CSavoy78/Maverick-DAQ/PCB/Maverick DAQ.kicad_pcb

## KiCad design PCB/Maverick DAQ.kicad_pcb (2025-04-01)

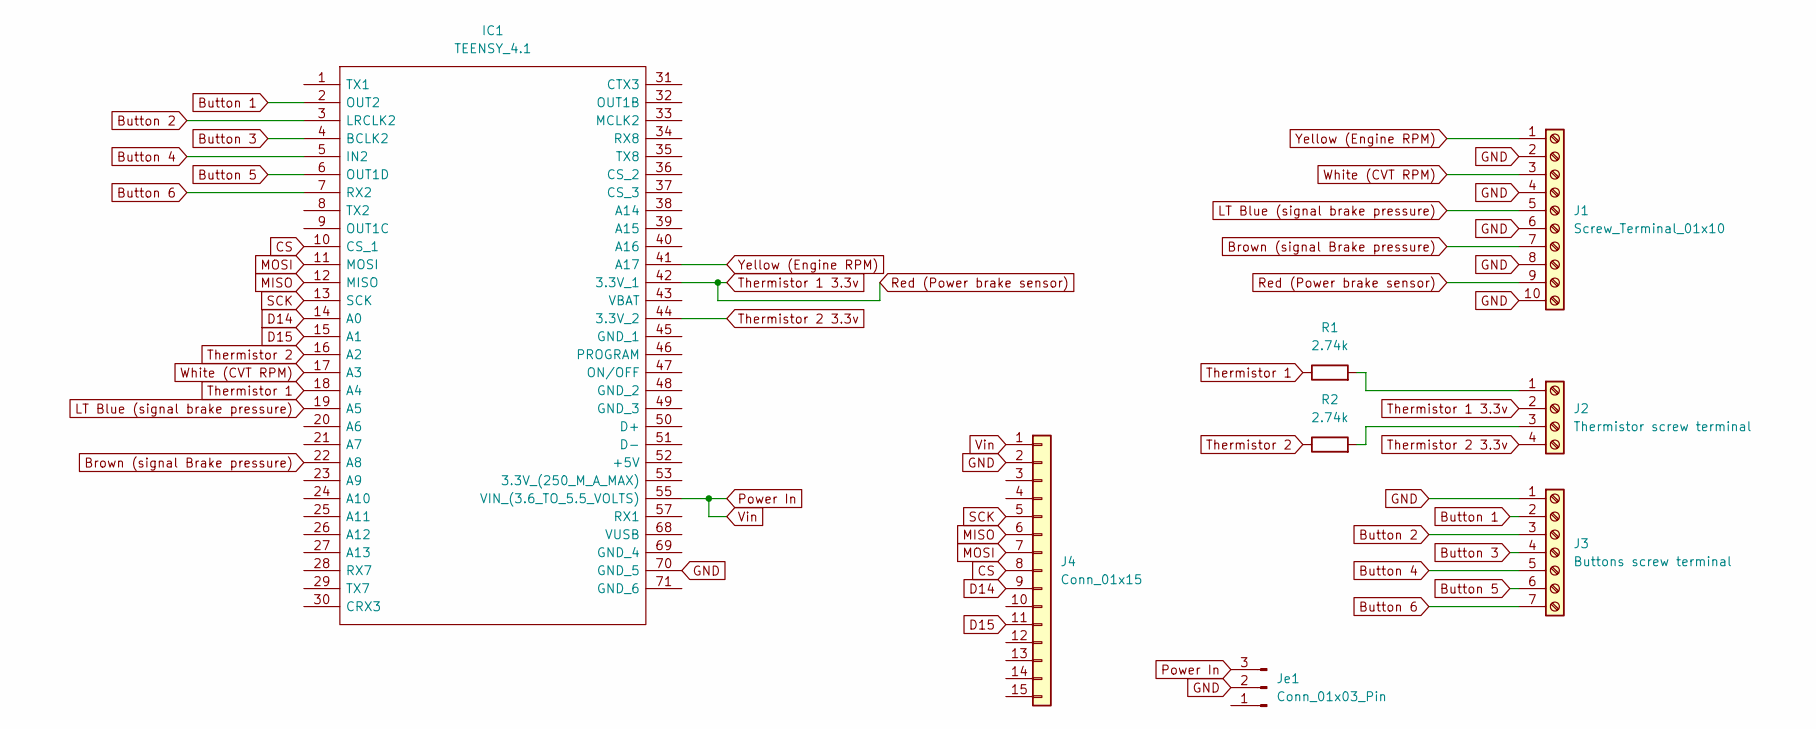
[picture p1: schematic Maverick DAQ.kicad_sch]

Parts:
IC1: TEENSY_4.1; TEENSY41; Manufacturer_Part_Number TEENSY 4.1
J1: Screw_Terminal_01x10; PinHeader_1x10_P2.54mm_Vertical
J2: Thermistor screw terminal; PinSocket_1x04_P2.54mm_Vertical
J3: Buttons screw terminal; PinSocket_1x07_P2.54mm_Vertical
J4: Conn_01x15; PinSocket_1x15_P2.54mm_Vertical
Je1: Conn_01x03_Pin; PinHeader_1x03_P2.54mm_Vertical
R1, R2: 2.74k; R_0402_1005Metric_Pad0.72x0.64mm_HandSolder

Connections:
Brown (signal Brake pressure): IC1.22 (A8), J1.7
Button 1: IC1.2 (OUT2), J3.2
Button 2: IC1.3 (LRCLK2), J3.3
Button 3: IC1.4 (BCLK2), J3.4
Button 4: IC1.5 (IN2), J3.5
Button 5: IC1.6 (OUT1D), J3.6
Button 6: IC1.7 (RX2), J3.7
CS: IC1.10 (CS_1), J4.8
D14: IC1.14 (A0), J4.9
D15: IC1.15 (A1), J4.11
GND: IC1.70 (GND_5), J1.2, J1.4, J1.6, J1.8, J1.10, J3.1, J4.2, Je1.2
LT Blue (signal brake pressure): IC1.19 (A5), J1.5
MISO: IC1.12 (MISO), J4.6
MOSI: IC1.11 (MOSI), J4.7
unnamed: J2.1, R1.2
unnamed: J2.3, R2.2
Power In: IC1.55 (VIN_(3.6_TO_5.5_VOLTS)), J4.1, Je1.3
Red (Power brake sensor): IC1.42 (3.3V_1), J1.9, J2.2
SCK: IC1.13 (SCK), J4.5
Thermistor 1: IC1.18 (A4), R1.1
Thermistor 2: IC1.16 (A2), R2.1
Thermistor 2 3.3v: IC1.44 (3.3V_2), J2.4
White (CVT RPM): IC1.17 (A3), J1.3
Yellow (Engine RPM): IC1.41 (A17), J1.1

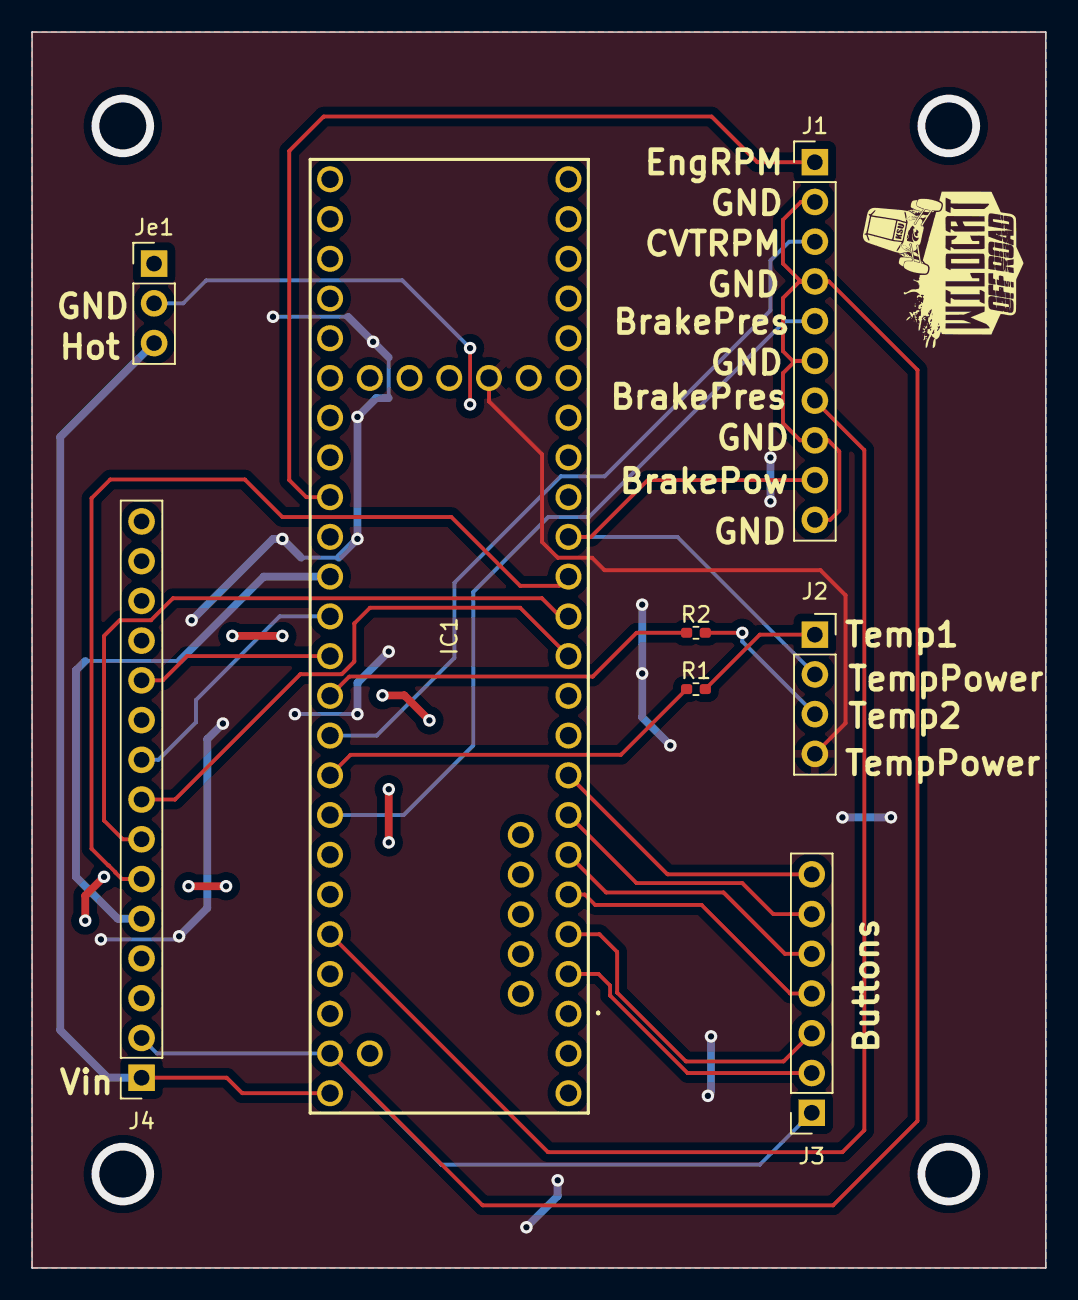
[picture p2: board Maverick DAQ.kicad_pcb from above]

Board: 2 copper layers, 64.8 x 79.0 mm, 8 parts (0 on the bottom side), 24 nets.
