CSavoy78/Maverick-DAQ/(commit log)

2025-04-01 Add files via upload
    New PCB design
    [Maverick DAQ.kicad_pcb, Maverick DAQ.kicad_sch]
2025-04-01 Delete PCB/git.keep
    useless file
2025-04-01 Delete Maverick DAQ.kicad_sch
    Moved to PCB
    [Maverick DAQ.kicad_sch]
2025-04-01 Delete Maverick DAQ.kicad_pro
    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
2025-04-01 Delete Maverick DAQ.kicad_pcb
    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
    [Maverick DAQ.kicad_pcb]
2025-04-01 Add files via upload
    Code for Maverick Teensy
2025-04-01 Delete Arduino Code/MAV DAQ Arduino.ino
    bad name, new file uploaded
2025-04-01 Delete Arduino Code/keep
    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
2025-04-01 Additional Excel File
    [Maverick DAQ.xlsx]
